pan224/TDC_UART/data_record.md

# 数据记录

> 注意：SEL000本身无数据。

## 第一次测试

### 数据信息

#### Merged 数据 (只含有 data.csv 的合并数据)

<details>
<summary>SEL001 - SCAN_100R_100P_20260108_141721</summary>

**Test Mode:** SCAN
**Timestamp:** 2026-01-08 14:17:21.764595

| Step | CSA | Samples | Mean (ps) | Variance | Std Dev (ps) |
| ---- | ----- | --- | --- | --- | --- |
| 0 | CSA_0 | 10000 | 11837.41  | 157.28 | 12.54 |
| 1 | CSA_1 | 10000 | 6955.51 | 224.47 | 14.98 |
| 2 | CSA_2 | 10000 | 2215.33 | 244.02 | 15.62 |
| 3 | CSA_3 | 10000 | -2492.48  | 244.08 | 15.62 |
| 4 | CSA_4 | 10000 | -7285.21  | 146.60 | 12.11 |
| 5 | CSA_5 | 10000 | -12098.23 | 164.15 | 12.81 |

</details>

<details>
<summary>SEL010 - SCAN_100R_100P_20260108_141454</summary>

**Test Mode:** SCAN
**Timestamp:** 2026-01-08 14:14:54.629893

| Step | CSA | Samples | Mean (ps) | Variance | Std Dev (ps) |
| ---- | ----- | --- | --- | --- | --- |
| 0 | CSA_0 | 10000 | 26645.60  | 172.76 | 13.14 |
| 1 | CSA_1 | 10000 | 15942.25  | 197.63 | 14.06 |
| 2 | CSA_2 | 10000 | 5293.12 | 251.64 | 15.86 |
| 3 | CSA_3 | 10000 | -5483.55  | 212.18 | 14.57 |
| 4 | CSA_4 | 10000 | -16218.55 | 261.02 | 16.16 |
| 5 | CSA_5 | 10000 | -26937.88 | 108.08 | 10.40 |

</details>

<details>
<summary>SEL011 - SCAN_100R_100P_20260108_141252</summary>

**Test Mode:** SCAN
**Timestamp:** 2026-01-08 14:12:52.722446

| Step | CSA | Samples | Mean (ps) | Variance | Std Dev (ps) |
| ---- | ----- | --- | --- | --- | --- |
| 0 | CSA_0 | 10000 | 35184.73  | 291.71 | 17.08 |
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
| 3 | CSA_3 | 10000 | -11804.49 | 150.87 | 12.28 |
| 4 | CSA_4 | 10000 | -35306.07 | 202.76 | 14.24 |
| 5 | CSA_5 | 10000 | -58854.17 | 250.13 | 15.82 |

</details>

<details>
<summary>SEL110 - SCAN_100R_100P_20260108_150920</summary>

**Test Mode:** SCAN
**Timestamp:** 2026-01-08 15:09:21.059514

| Step | CSA | Samples | Mean (ps) | Variance | Std Dev (ps) |
| ---- | ----- | --- | --- | --- | --- |
| 0 | CSA_0 | 10000 | 73347.67  | 222.75 | 14.92 |
| 1 | CSA_1 | 10000 | 43995.64  | 237.52 | 15.41 |
| 2 | CSA_2 | 10000 | 14653.28  | 172.40 | 13.13 |
| 3 | CSA_3 | 10000 | -14735.75 | 148.98 | 12.21 |
| 4 | CSA_4 | 10000 | -44152.21 | 220.49 | 14.85 |
| 5 | CSA_5 | 10000 | -73620.59 | 248.90 | 15.78 |

</details>

<details>
<summary>SEL111 - SCAN_100R_100P_20260108_151229</summary>

**Test Mode:** SCAN
**Timestamp:** 2026-01-08 15:12:29.540880

| Step | CSA | Samples | Mean (ps) | Variance | Std Dev (ps) |
| ---- | ----- | --- | --- | --- | --- |
| 0 | CSA_0 | 10000 | 81916.04  | 323.14 | 17.98 |
| 1 | CSA_1 | 10000 | 49102.85  | 239.94 | 15.49 |
| 2 | CSA_2 | 10000 | 16363.34  | 155.50 | 12.47 |
| 3 | CSA_3 | 10000 | -16432.14 | 123.28 | 11.10 |
| 4 | CSA_4 | 10000 | -49276.20 | 205.43 | 14.33 |
| 5 | CSA_5 | 10000 | -82184.24 | 321.65 | 17.93 |

</details>

#### 数据分析

---

**单位延时分析 - 第一次测试 (2026-01-08)**

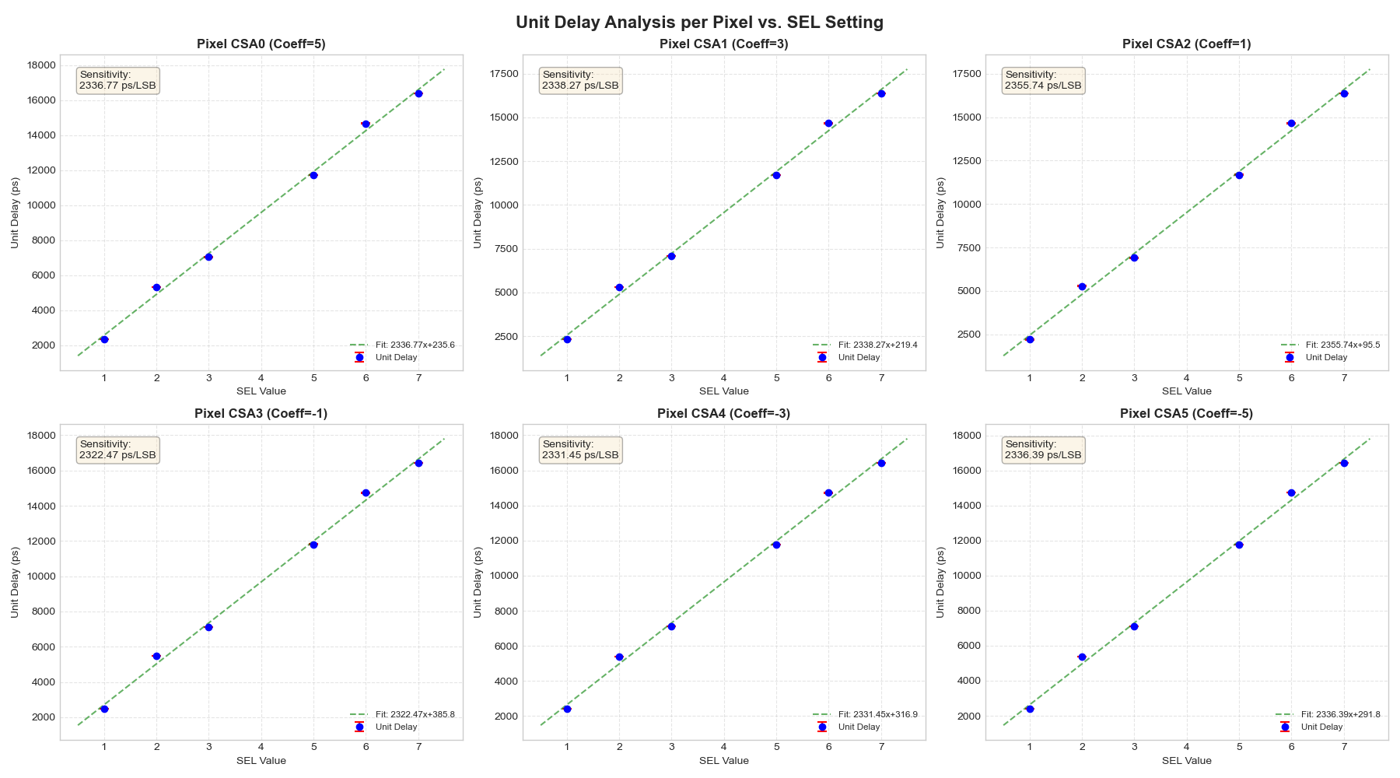
[picture p1: data/Unit_Delay_Analysis_20260108_165742.png]


**单位延时分析 - 修正后对比 (2026-01-21)**

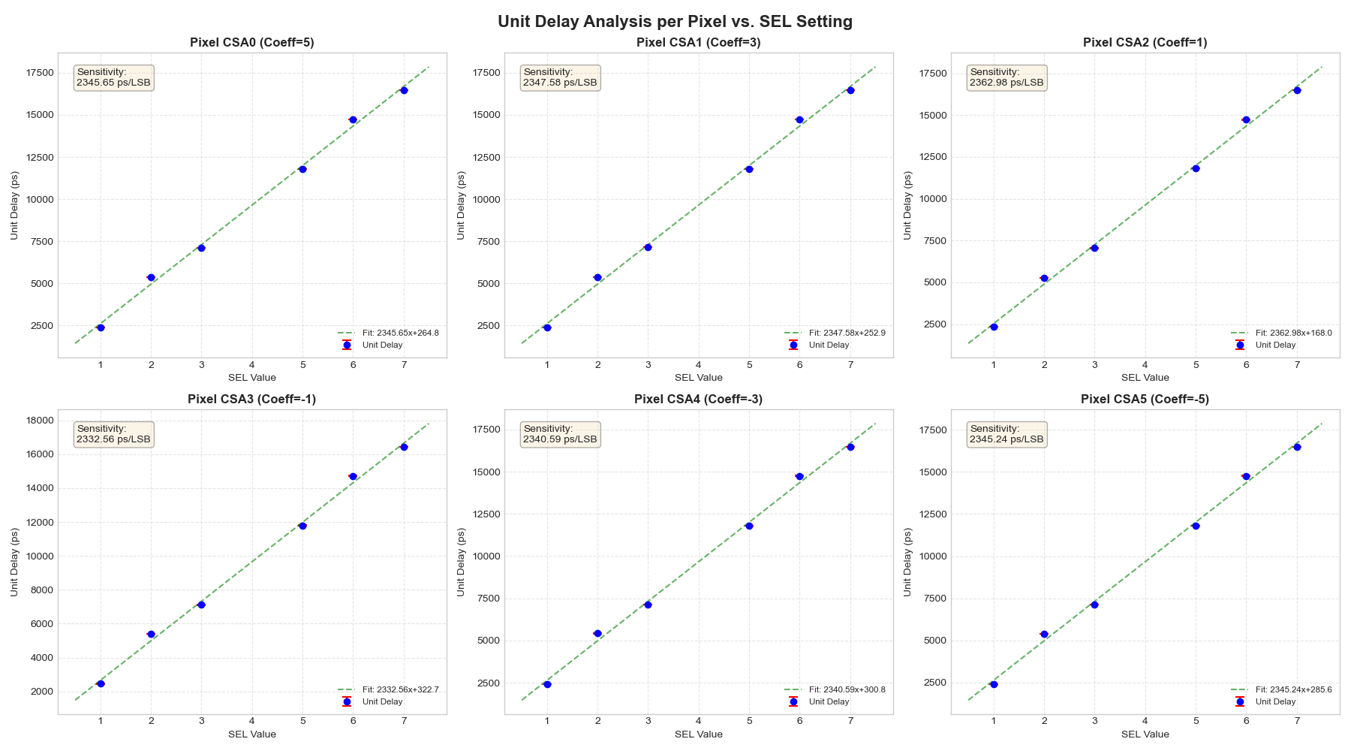
[picture p2: data/Unit_Delay_Analysis_20260121_174906.png]


---

### 数据记录说明

**测试硬件：** 初代测试板
**测试日期：** 2026-01-08
**数据类型：** 两组

**主要发现：**

- 无法采集 SEL100 数据，怀疑硬件问题
- 成功采集其他 SEL 配置的完整数据

**数据组成：**

1. **Merged 数据** - 仅包含 data.csv 合并数据
2. **CSA Split 数据** - 包含 CSA0-CSA5 各通道独立数据

## 第二次测试

### 数据信息

- 时间：2026-01-21
- 测试数据：CSA Split
- 注：SEL100 缺失

<details>
<summary>SEL001 - SCAN_100R_100P_20260121_172647</summary>

**Test Mode:** SCAN
**Timestamp:** 2026-01-21 17:26:47.961069

| Step | CSA | Samples | Mean (ps) | Variance | Std Dev (ps) |
| ---- | ----- | --- | --- | --- | --- |
| 0 | CSA_0 | 10000 | 11989.13  | 93.80 | 9.68 |
| 1 | CSA_1 | 10000 | 7083.89 | 82.24 | 9.07 |
| 2 | CSA_2 | 10000 | 2344.18 | 82.53 | 9.08 |
| 3 | CSA_3 | 10000 | -2456.50  | 94.73 | 9.73 |
| 4 | CSA_4 | 10000 | -7252.38  | 91.81 | 9.58 |
| 5 | CSA_5 | 10000 | -12091.16 | 117.69 | 10.85 |

</details>

<details>
<summary>SEL010 - SCAN_100R_100P_20260121_172841</summary>

**Test Mode:** SCAN
**Timestamp:** 2026-01-21 17:28:41.288427

| Step | CSA | Samples | Mean (ps) | Variance | Std Dev (ps) |
| ---- | ----- | --- | --- | --- | --- |
| 0 | CSA_0 | 10000 | 26882.59  | 113.91 | 10.67 |
| 1 | CSA_1 | 10000 | 16103.95  | 107.02 | 10.35 |
| 2 | CSA_2 | 10000 | 5275.56 | 96.07 | 9.80 |
| 3 | CSA_3 | 10000 | -5394.46  | 108.51 | 10.42 |
| 4 | CSA_4 | 10000 | -16246.74 | 89.51 | 9.46 |
| 5 | CSA_5 | 10000 | -26997.04 | 102.31 | 10.11 |

</details>

<details>
<summary>SEL011 - SCAN_100R_100P_20260121_173049</summary>

**Test Mode:** SCAN
**Timestamp:** 2026-01-21 17:30:49.272076

| Step | CSA | Samples | Mean (ps) | Variance | Std Dev (ps) |
| ---- | ----- | --- | --- | --- | --- |
| 0 | CSA_0 | 10000 | 35470.05  | 132.57 | 11.51 |
| 1 | CSA_1 | 10000 | 21401.14  | 121.46 | 11.02 |
| 2 | CSA_2 | 10000 | 7041.95 | 80.69 | 8.98 |
| 3 | CSA_3 | 10000 | -7104.07  | 90.13 | 9.49 |
| 4 | CSA_4 | 10000 | -21347.91 | 132.44 | 11.51 |
| 5 | CSA_5 | 10000 | -35547.15 | 131.29 | 11.46 |

</details>

<details>
<summary>SEL100 - 示波器测试数据</summary>

**Test Mode:** OSCILLOSCOPE
**Timestamp:** 2026-01-21
**Note:** SEL100脉冲幅度约 200mV

---

**CSA0 通道 (测量值: 47720 ps)**

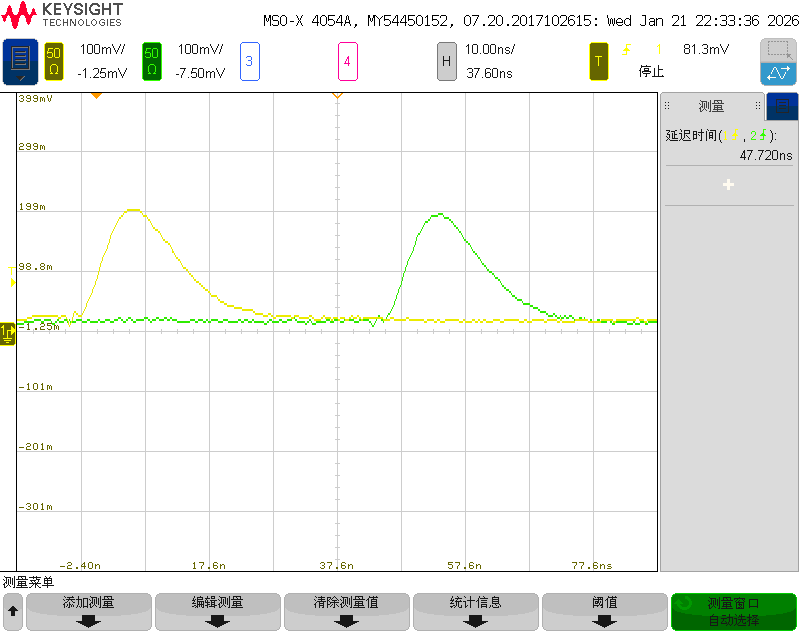
[picture p3: data/SEL100/示波器测试数据/CSA0.png]
CSA0波形


**CSA1 通道 (测量值: 26244 ps)**

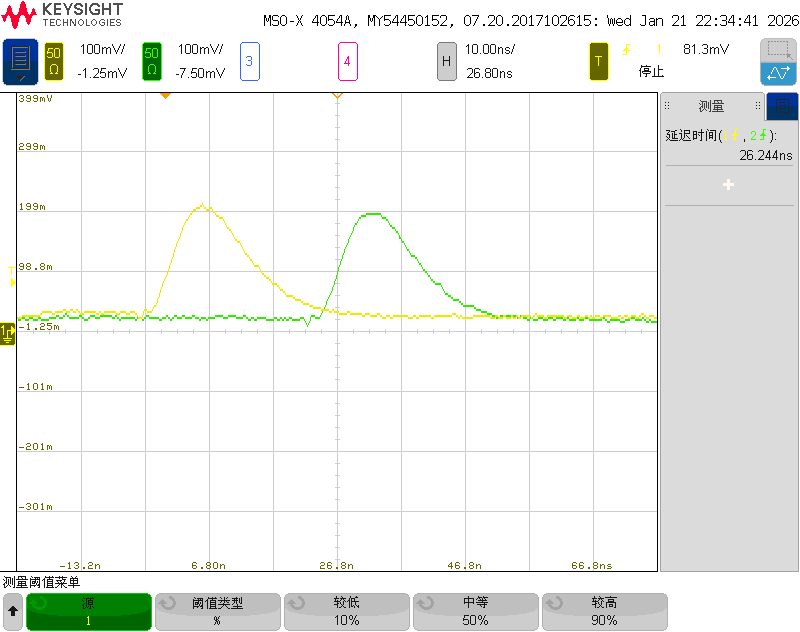
[picture p4: data/SEL100/示波器测试数据/CSA1.png]
CSA1波形


**CSA2 通道 (测量值: 8852 ps)**

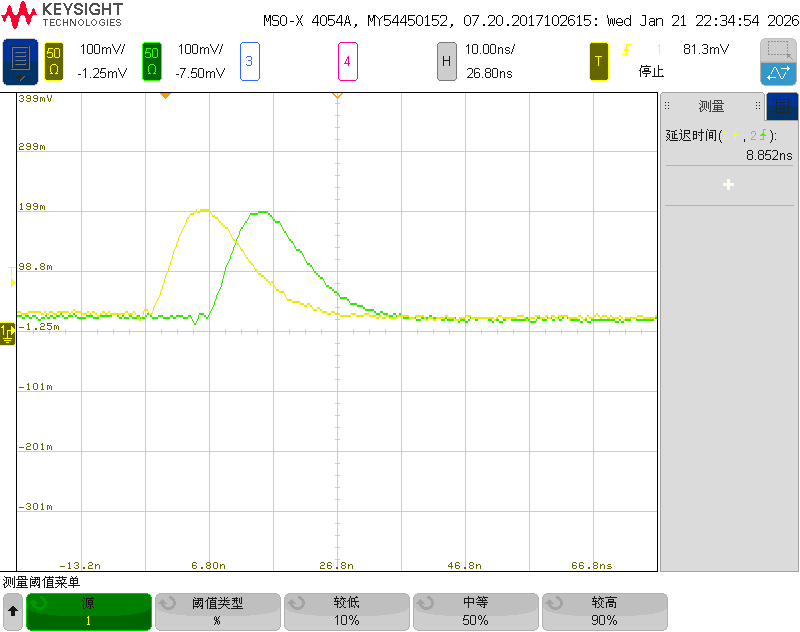
[picture p5: data/SEL100/示波器测试数据/CSA2.png]
CSA2波形


**CSA3 通道 (测量值: -10577 ps)**

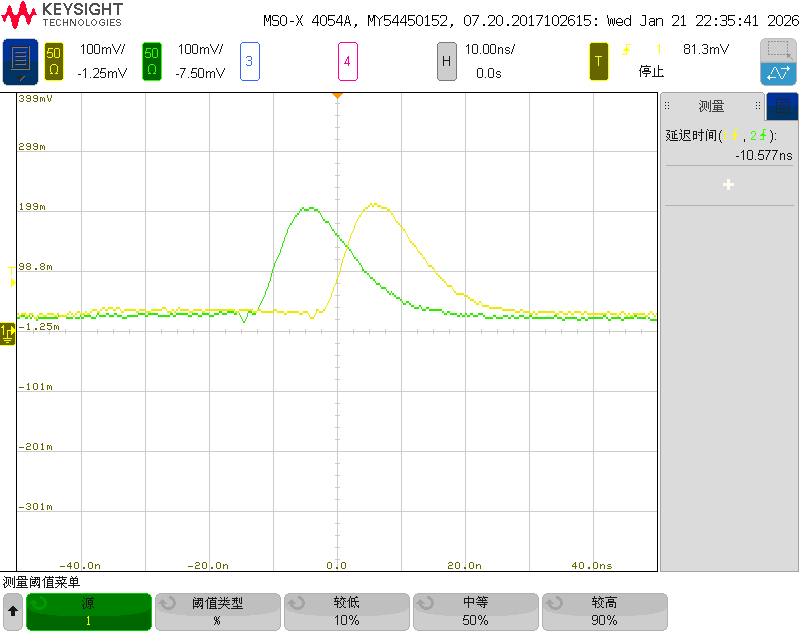
[picture p6: data/SEL100/示波器测试数据/CSA3.png]
CSA3波形


**CSA4 通道 (测量值: -27960 ps)**

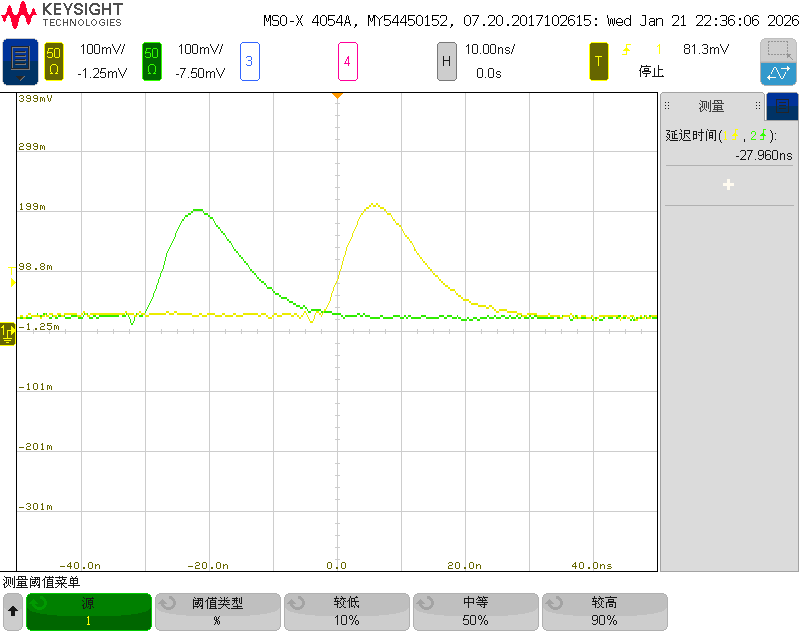
[picture p7: data/SEL100/示波器测试数据/CSA4.png]
CSA4波形


**CSA5 通道 (测量值: -45367 ps)**

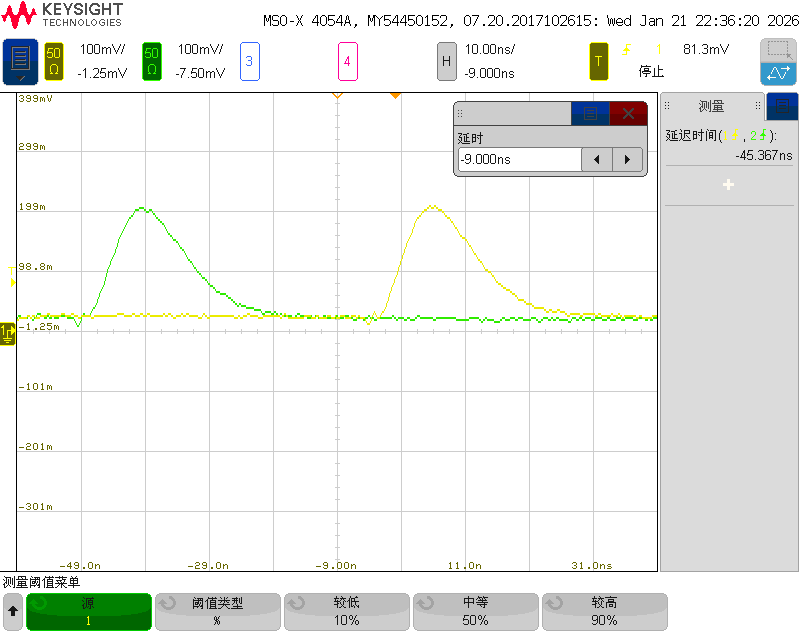
[picture p8: data/SEL100/示波器测试数据/CSA5.png]
CSA5波形


---

**测量数据汇总**

| 通道 | 时间差 (ps) |
| ---- | --- |
| CSA0 | 47720 |
| CSA1 | 26244 |
| CSA2 | 8852 |
| CSA3 | -10577 |
| CSA4 | -27960 |
| CSA5 | -45367 |

</details>

<details>
<summary>SEL101 - SCAN_100R_100P_20260121_173301</summary>

**Test Mode:** SCAN
**Timestamp:** 2026-01-21 17:33:01.628801

| Step | CSA | Samples | Mean (ps) | Variance | Std Dev (ps) |
| ---- | ----- | --- | --- | --- | --- |
| 0 | CSA_0 | 10000 | 58955.12  | 187.81 | 13.70 |
| 1 | CSA_1 | 10000 | 35338.72  | 142.73 | 11.95 |
| 2 | CSA_2 | 10000 | 11828.26  | 112.20 | 10.59 |
| 3 | CSA_3 | 10000 | -11795.52 | 92.89 | 9.64 |
| 4 | CSA_4 | 10000 | -35399.06 | 121.82 | 11.04 |
| 5 | CSA_5 | 10000 | -59046.35 | 200.68 | 14.17 |

</details>

<details>
<summary>SEL110 - SCAN_100R_100P_20260121_173655</summary>

**Test Mode:** SCAN
**Timestamp:** 2026-01-21 17:36:55.768046

| Step | CSA | Samples | Mean (ps) | Variance | Std Dev (ps) |
| ---- | ----- | --- | --- | --- | --- |
| 0 | CSA_0 | 10000 | 73734.26  | 223.46 | 14.95 |
| 1 | CSA_1 | 10000 | 44232.12  | 181.41 | 13.47 |
| 2 | CSA_2 | 10000 | 14728.77  | 94.31 | 9.71 |
| 3 | CSA_3 | 10000 | -14722.61 | 94.14 | 9.70 |
| 4 | CSA_4 | 10000 | -44262.89 | 180.69 | 13.44 |
| 5 | CSA_5 | 10000 | -73844.62 | 221.73 | 14.89 |

</details>

<details>
<summary>SEL111 - SCAN_100R_100P_20260121_173451</summary>

**Test Mode:** SCAN
**Timestamp:** 2026-01-21 17:34:51.170206

| Step | CSA | Samples | Mean (ps) | Variance | Std Dev (ps) |
| ---- | ----- | --- | --- | --- | --- |
| 0 | CSA_0 | 10000 | 82389.86  | 239.30 | 15.47 |
| 1 | CSA_1 | 10000 | 49418.06  | 163.49 | 12.79 |
| 2 | CSA_2 | 10000 | 16501.09  | 118.09 | 10.87 |
| 3 | CSA_3 | 10000 | -16444.45 | 103.70 | 10.18 |
| 4 | CSA_4 | 10000 | -49427.68 | 165.79 | 12.88 |
| 5 | CSA_5 | 10000 | -82470.95 | 227.06 | 15.07 |

</details>

#### 数据分析

---

**单位延时分析 - 第二次测试 (2026-01-21)**

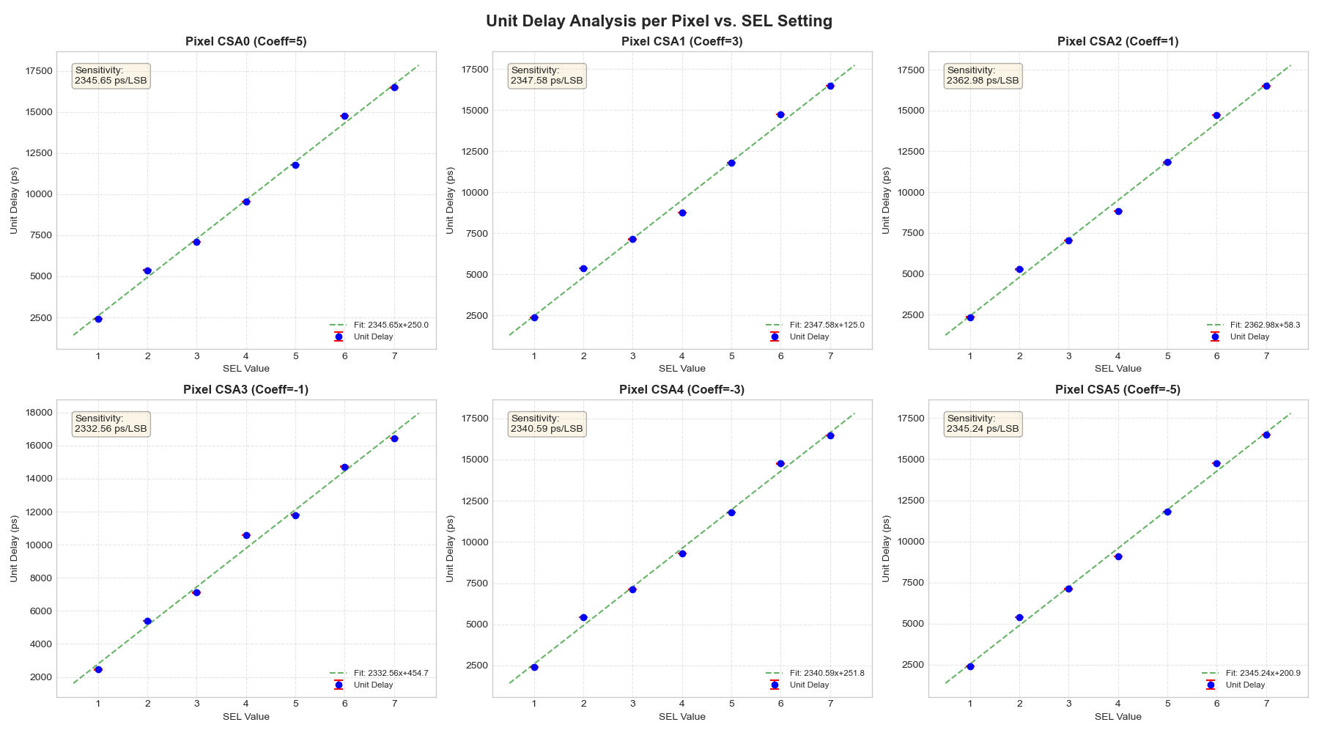
[picture p9: data/Unit_Delay_Analysis_20260121_213557.png]


> 注：此次测试附带了示波器采集的 SEL100 测试数据

---

### 数据记录说明

**测试硬件：** 重新焊接的新测试板
**测试日期：** 2026-01-21
**数据类型：** CSA Split

**重要改进：**

- 修正代码错误：260MHz 对应周期从 3864ps 更正为 3846ps
- 数据标准差显著降低，测量精度提升

**问题分析：**

- SEL100 数据仍无法通过 TDC 采集
- 根本原因：像素芯片输出脉冲幅度过小（约 200mV）
- 脉冲幅度不足以触发 TDC 系统的阈值

**解决方案：**
采用示波器直接测量 SEL100 输出波形时间差（详见上方示波器测试数据）

---

**示波器测量结果总结：**

| 通道 | 时间差 (ps) | 备注 |
| ---- | --- | --- |
| CSA0 | 47720 | 最大正延时 |
| CSA1 | 26244 | |
| CSA2 | 8852 | |
| CSA3 | -10577 | |
| CSA4 | -27960 | |
| CSA5 | -45367 | 最大负延时 |

> 注：SEL100 脉冲幅度在示波器下测得约 200mV

---

## 第三次测试

### 测试内容

**测试日期：** 2026-03-25
**测试方式：** 内部记录信号（UP/DOWN 双通道）全步进统计
**数据文件时间戳：** 2026-03-25 09:06:59

### 数据信息

- 扫描范围：Phase Step 0~224（共 225 点）
- 每个相位点配对样本数：3000
- 统计数据文件：`full_phase_stats_0_224_20260325_094752.csv`
- 输出四子图：`full_phase_stats_0_224_20260325_094752.png`

#### 关键统计汇总

| 指标 | UP 通道 | DOWN 通道 |
| --- | --- | --- |
| 均值范围（Phase 0~224） | 36.733~3805.460 ps | 31.414~3808.775 ps |
| 标准差均值（过滤异常点） | 13.064 ps | 12.283 ps |
| 过滤异常点（Phase 200~205） | 6个 | 6个 |

#### 数据分析图

**UP/DOWN 均值与标准差（按 Phase Step）**

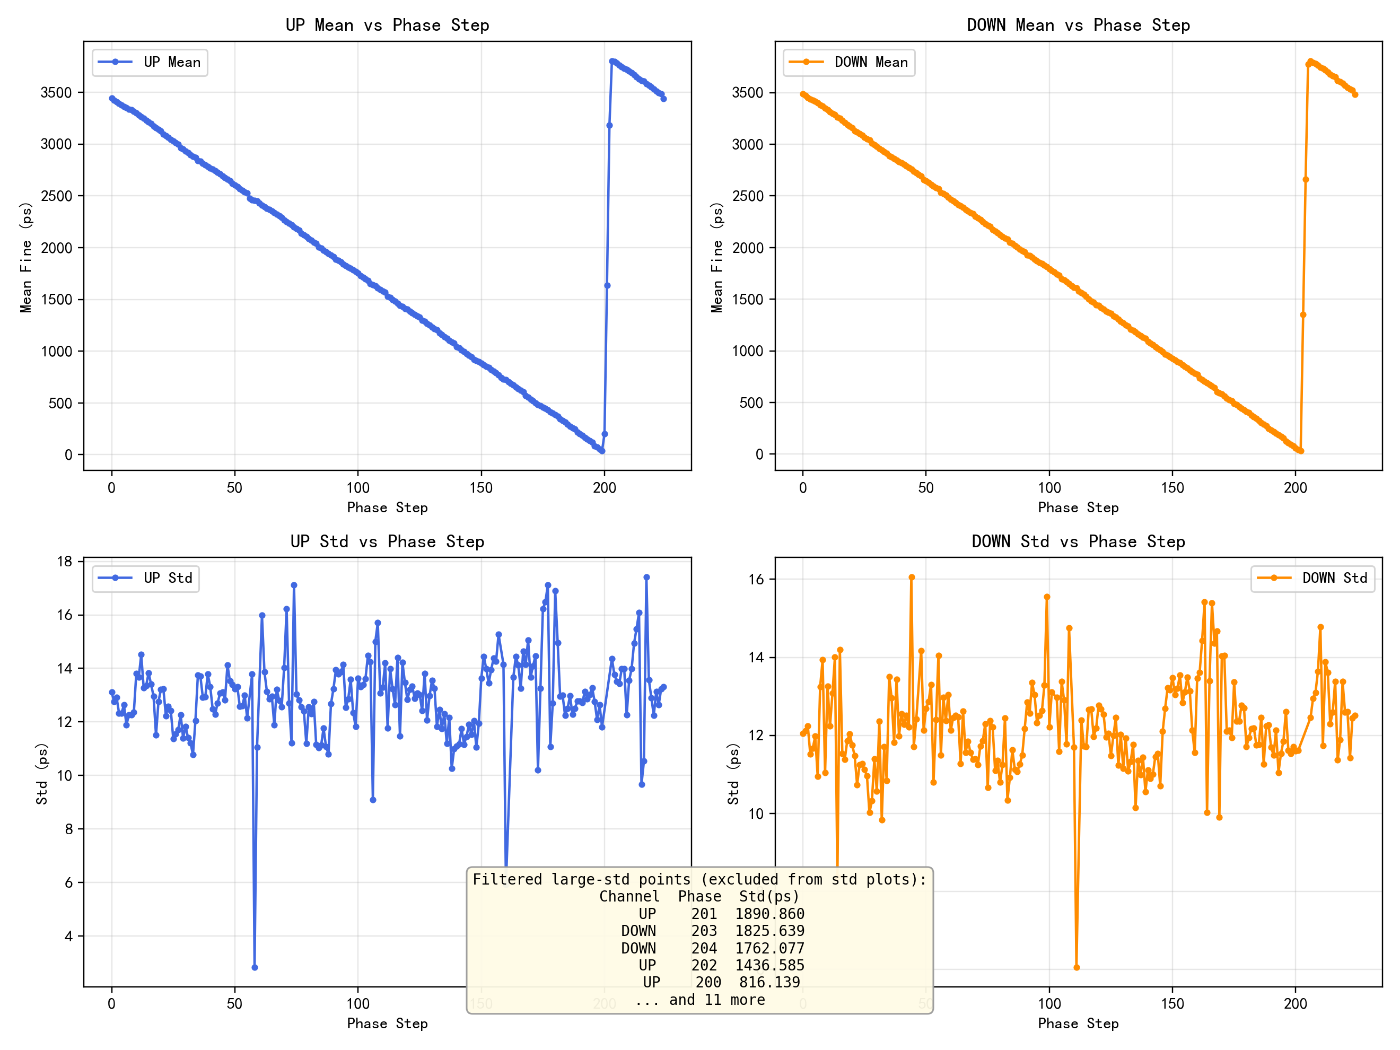
[picture p10: tdc_results/full_phase_stats_0_224_20260325_094752.png]
第三次测试四子图


- 四子图图表已生成，展示 Phase 0~224 全范围数据
- 上图：UP/DOWN 通道均值对比（线性趋势）
- 下图：UP/DOWN 通道标准差对比（异常点已标注）

---

## 第四次测试

### 测试内容

**测试日期：** 2026-03-25
**测试方式：** UART 全扫描（UP/DOWN 同步记录）
**原始数据文件：** `tdc_uart_全扫描_both_20260325_090659.txt`

### 数据信息

- 扫描步进：0~224（共 225 点）
- 每步记录：UP 1 点 + DOWN 1 点
- 总记录数：450 条（UP 225 条，DOWN 225 条）
- 综合分析图：`tdc_uart_全扫描_both_20260325_090659.png`

#### 关键统计汇总

| 指标 | UP 通道 | DOWN 通道 |
| --- | --- | --- |
| Fine 范围 | 6~3822 | 18~3840 |
| Coarse 范围 | 116~117 | 138~139 |
| 截断后线性拟合斜率（图中） | ~0.997 ps/ps | ~0.998 ps/ps |
| 线性度指标（图中） | DNL RMS = 0.887 LSB | INL RMS = 0.777 LSB |

#### 数据分析图

**全扫描综合分析（Fine/Coarse、线性拟合、DNL/INL）**

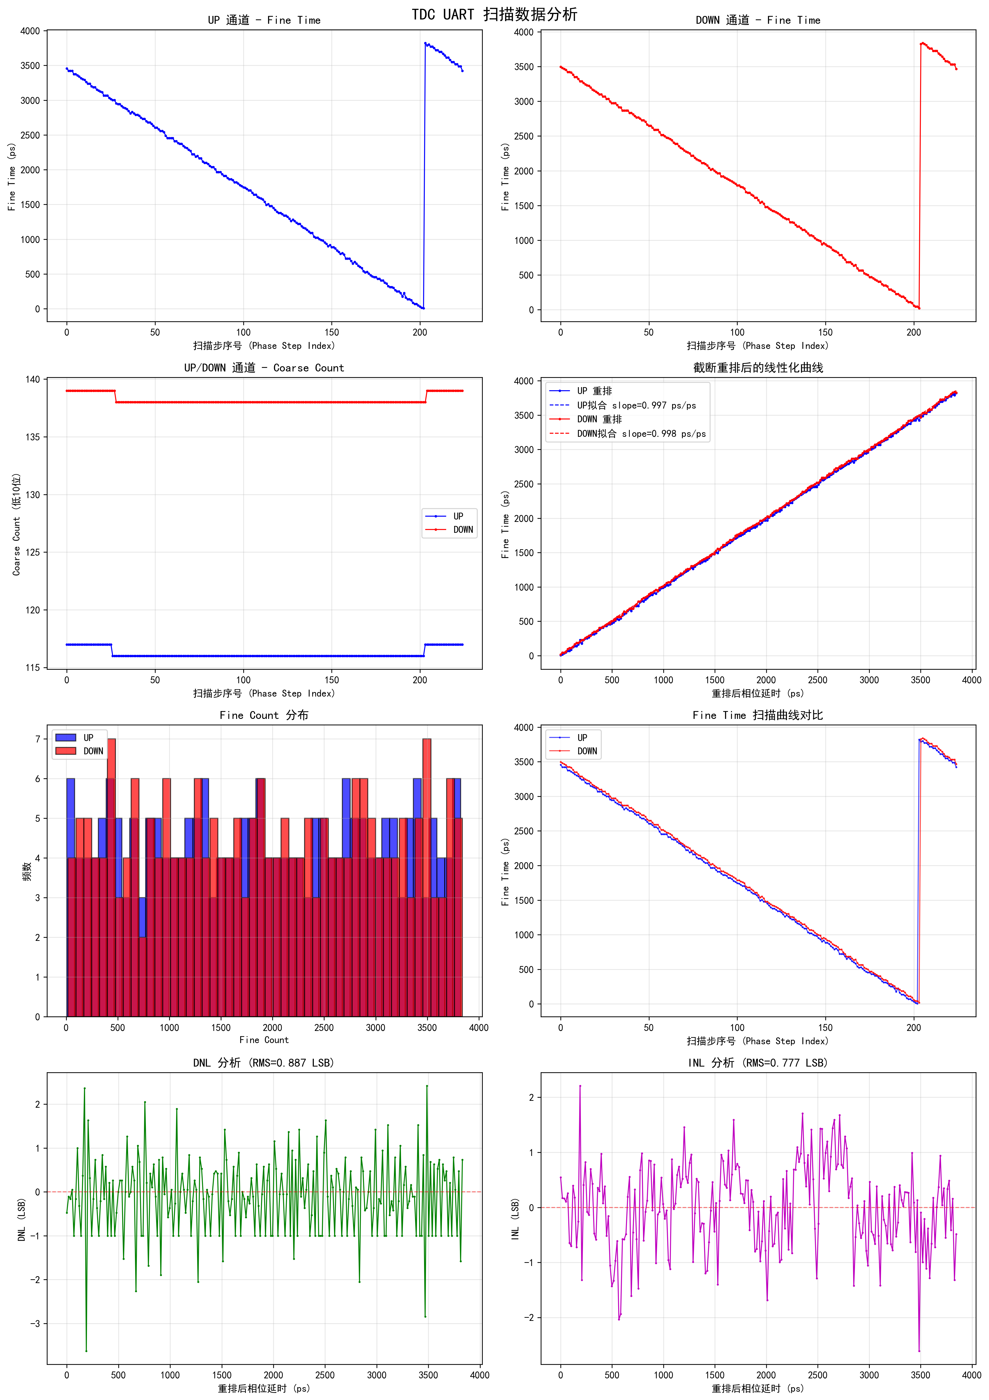
[picture p11: tdc_results/tdc_uart_全扫描_both_20260325_090659.png]
全扫描综合分析图


**图中结论（关键点）：**

- UP/DOWN Fine 曲线在主区间基本线性，约在 Phase 200 附近出现翻转（计数回绕）
- Coarse 计数稳定在窄范围内（UP: 116-117，DOWN: 138-139）
- 截断后拟合曲线显示 UP/DOWN 斜率一致性较好
- DNL/INL 均处于较小 RMS 区间，整体线性度表现稳定
