pan224/TDC_UART/data/SEL001/SCAN_100R_100P_20260121_172647/analysis_plot.png

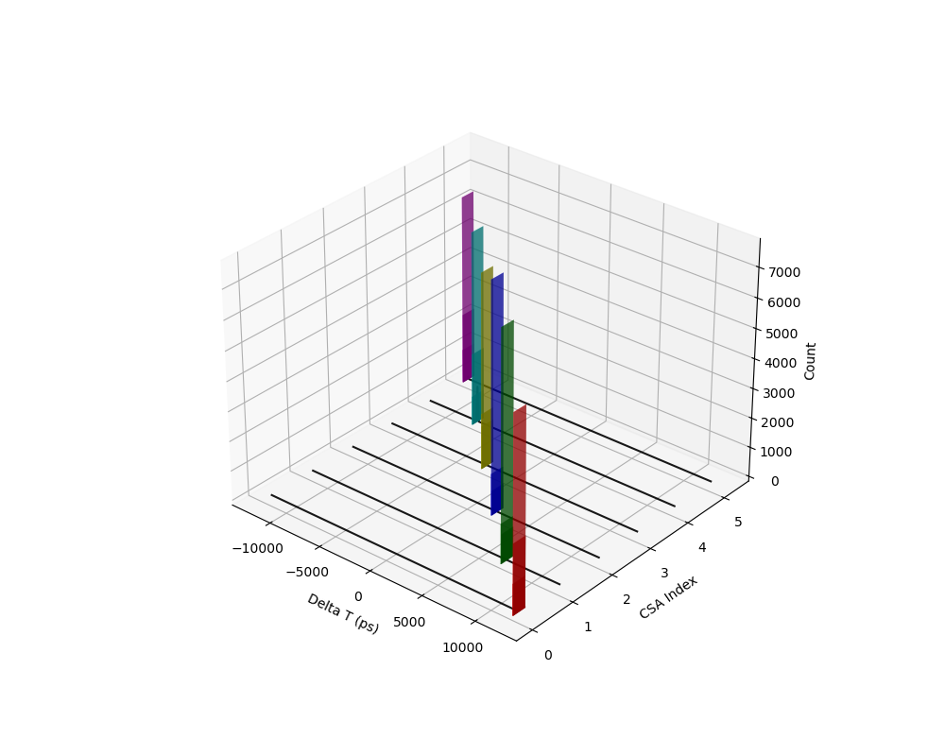
data/SEL001/SCAN_100R_100P_20260121_172647/analysis_plot.png
