pan224/TDC_UART/tdc_results/full_phase_stats_0_224_20260325_094752.csv

phase | valid_pairs | up_mean_ps | up_var_ps2 | up_std_ps | down_mean_ps | down_var_ps2 | down_std_ps
0 | 3000 | 3442.133333 | 172.073556 | 13.117681 | 3486.451000 | 145.099599 | 12.045729
1 | 3000 | 3425.267333 | 162.701866 | 12.755464 | 3470.178333 | 147.031197 | 12.125642
2 | 3000 | 3407.602667 | 166.858126 | 12.917358 | 3452.416000 | 149.738944 | 12.236787
3 | 3000 | 3393.896667 | 152.088656 | 12.332423 | 3439.053000 | 132.682858 | 11.518805
4 | 3000 | 3377.633667 | 152.044133 | 12.330618 | 3425.560333 | 136.147027 | 11.668206
5 | 3000 | 3364.103333 | 159.679322 | 12.636428 | 3413.706000 | 143.576231 | 11.982330
6 | 3000 | 3352.900000 | 141.532000 | 11.896722 | 3403.185667 | 119.966528 | 10.952923
7 | 3000 | 3338.623333 | 150.220789 | 12.256459 | 3379.205333 | 175.463838 | 13.246276
8 | 3000 | 3332.157000 | 150.494351 | 12.267614 | 3368.684000 | 194.164811 | 13.934303
9 | 3000 | 3316.962667 | 152.659273 | 12.355536 | 3351.288667 | 121.976672 | 11.044305
10 | 3000 | 3299.014667 | 190.626452 | 13.806754 | 3334.443667 | 175.834827 | 13.260272
11 | 3000 | 3279.770333 | 186.966920 | 13.673585 | 3314.914333 | 149.860995 | 12.241773
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
