pan224/TDC_UART/tdc_results/GUI_data/1.csv

Time | Ch | ID | Coarse | Fine | CoarseDiff | Delta_ps | RawHex
20:49:22.750 | UP | 0 | 201 | 1789 |  |  | 0x000DFBC9
20:49:22.750 | DOWN | 0 | 220 | 1066 | 19 | 73416.37 | 0x400854DC
20:49:22.750 | UP | 1 | 111 | 2103 |  |  | 0x00506F6F
20:49:22.750 | DOWN | 1 | 130 | 1396 | 19 | 73408.86 | 0x404AE882
20:49:22.750 | UP | 2 | 21 | 2553 |  |  | 0x0093F315
20:49:22.750 | DOWN | 2 | 40 | 1800 | 19 | 73430.46 | 0x408E1028
20:49:22.750 | UP | 3 | 187 | 2926 |  |  | 0x00D6DDBB
20:49:22.750 | DOWN | 3 | 206 | 2204 | 19 | 73415.90 | 0x40D138CE
20:49:22.750 | UP | 4 | 97 | 3341 |  |  | 0x011A1B61
20:49:22.750 | DOWN | 4 | 116 | 2592 | 19 | 73428.58 | 0x41144074
20:49:22.750 | UP | 5 | 7 | 3687 |  |  | 0x015CCF07
20:49:22.750 | DOWN | 5 | 26 | 2957 | 19 | 73419.66 | 0x41571A1A
20:49:22.750 | UP | 6 | 172 | 187 |  |  | 0x018177AC
20:49:22.750 | DOWN | 6 | 192 | 3325 | 20 | 75449.78 | 0x4199FAC0
20:49:22.750 | UP | 7 | 82 | 606 |  |  | 0x01C4BD52
20:49:22.750 | DOWN | 7 | 102 | 3744 | 20 | 75449.78 | 0x41DD4066
20:49:22.750 | UP | 8 | 248 | 940 |  |  | 0x020759F8
20:49:22.750 | DOWN | 8 | 11 | 244 | 19 | 73403.70 | 0x4201E80B
20:49:22.750 | UP | 9 | 158 | 1356 |  |  | 0x024A999E
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
