pan224/TDC_UART/tdc_results/GUI_data/2.csv

Time | Ch | ID | Coarse | Fine | CoarseDiff | Delta_ps | RawHex
21:02:26.541 | UP | 216 | 101 | 223 |  |  | 0x3601BF65
21:02:26.541 | DOWN | 216 | 121 | 3383 | 19* | 71593.30 | 0x761A6E79
21:02:26.541 | UP | 217 | 11 | 625 |  |  | 0x3644E30B
21:02:26.541 | DOWN | 217 | 31 | 3765 | 19* | 71602.69 | 0x765D6A1F
21:02:26.541 | UP | 218 | 177 | 987 |  |  | 0x3687B7B1
21:02:26.541 | DOWN | 218 | 196 | 226 | 19 | 73434.21 | 0x7681C4C4
21:02:26.541 | UP | 219 | 87 | 1346 |  |  | 0x36CA8557
21:02:26.541 | DOWN | 219 | 106 | 619 | 19 | 73418.25 | 0x76C4D66A
21:02:26.541 | UP | 220 | 253 | 1775 |  |  | 0x370DDFFD
21:02:26.541 | DOWN | 220 | 16 | 1043 | 19 | 73420.60 | 0x77082610
21:02:26.541 | UP | 221 | 163 | 2131 |  |  | 0x3750A7A3
21:02:26.541 | DOWN | 221 | 182 | 1396 | 19 | 73422.01 | 0x774AE8B6
21:02:26.541 | UP | 222 | 73 | 2506 |  |  | 0x37939549
21:02:26.541 | DOWN | 222 | 92 | 1767 | 19 | 73423.88 | 0x778DCE5C
21:02:26.541 | UP | 223 | 239 | 2907 |  |  | 0x37D6B7EF
21:02:26.541 | DOWN | 223 | 2 | 2161 | 19 | 73427.17 | 0x77D0E202
21:02:26.541 | UP | 224 | 149 | 3357 |  |  | 0x381A3B95
21:02:26.541 | DOWN | 224 | 168 | 2618 | 19 | 73423.88 | 0x781474A8
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
