pan224/TDC_UART/tdc_results/GUI_data/3.csv

Time | Ch | ID | Coarse | Fine | CoarseDiff | FineDiff | Delta_ps | RawHex
21:26:56.892 | UP | 188 | 202 | 2186 |  |  |  | 0x2F1115CA
21:26:56.892 | DOWN | 188 | 221 | 1410 | 19 | -776 | 73441.26 | 0x6F0B04DD
21:26:56.892 | UP | 189 | 112 | 2575 |  |  |  | 0x2F541F70
21:26:56.892 | DOWN | 189 | 131 | 1827 | 19 | -748 | 73428.11 | 0x6F4E4683
21:26:56.893 | UP | 190 | 22 | 2906 |  |  |  | 0x2F96B516
21:26:56.893 | DOWN | 190 | 41 | 2161 | 19 | -745 | 73426.70 | 0x6F90E229
21:26:56.893 | UP | 191 | 188 | 3273 |  |  |  | 0x2FD993BC
21:26:56.893 | DOWN | 191 | 207 | 2518 | 19 | -755 | 73431.40 | 0x6FD3ACCF
21:26:56.893 | UP | 192 | 98 | 3709 |  |  |  | 0x301CFB62
21:26:56.893 | DOWN | 192 | 117 | 2957 | 19 | -752 | 73429.99 | 0x70171A75
21:26:56.893 | UP | 193 | 7 | 200 |  |  |  | 0x30419107
21:26:56.893 | DOWN | 193 | 27 | 3338 | 20 | 3138 | 75449.78 | 0x705A141B
21:26:56.893 | UP | 194 | 173 | 568 |  |  |  | 0x308471AD
21:26:56.893 | DOWN | 194 | 193 | 3686 | 20 | 3118 | 75459.17 | 0x709CCCC1
21:26:56.893 | UP | 195 | 83 | 957 |  |  |  | 0x30C77B53
21:26:56.893 | DOWN | 195 | 102 | 227 | 19 | -730 | 73419.66 | 0x70C1C666
21:26:56.893 | UP | 196 | 249 | 1344 |  |  |  | 0x310A81F9
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
