pan224/TDC_UART/tdc_results/tdc_uart_全扫描_both_20260409_131519.png

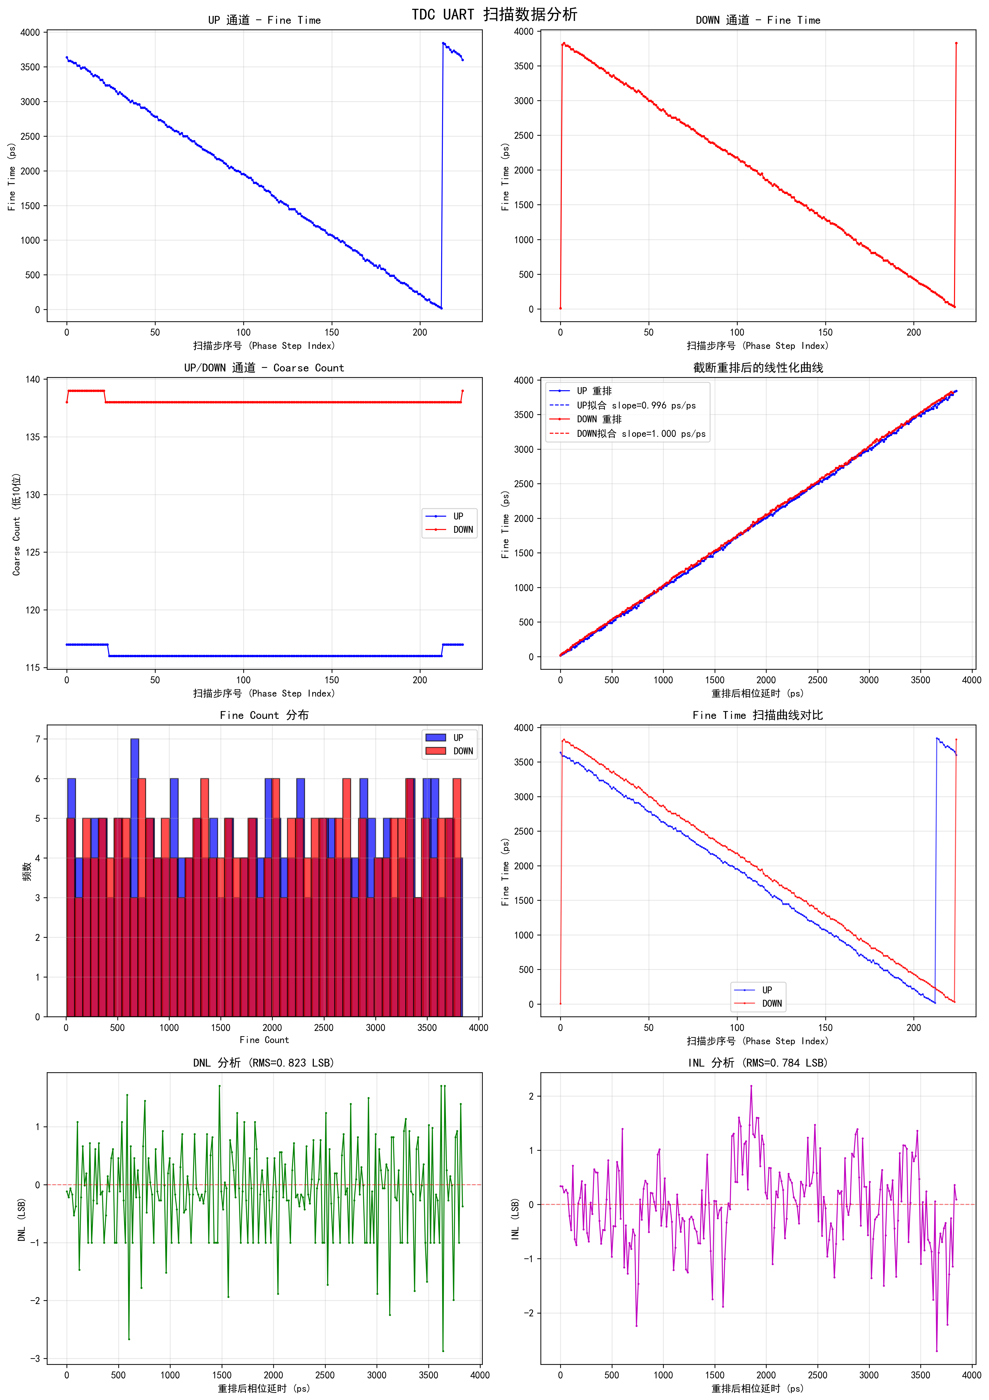
tdc_results/tdc_uart_全扫描_both_20260409_131519.png
