pan224/TDC_UART/tdc_results/扫描，粗计数在channel外进行.png

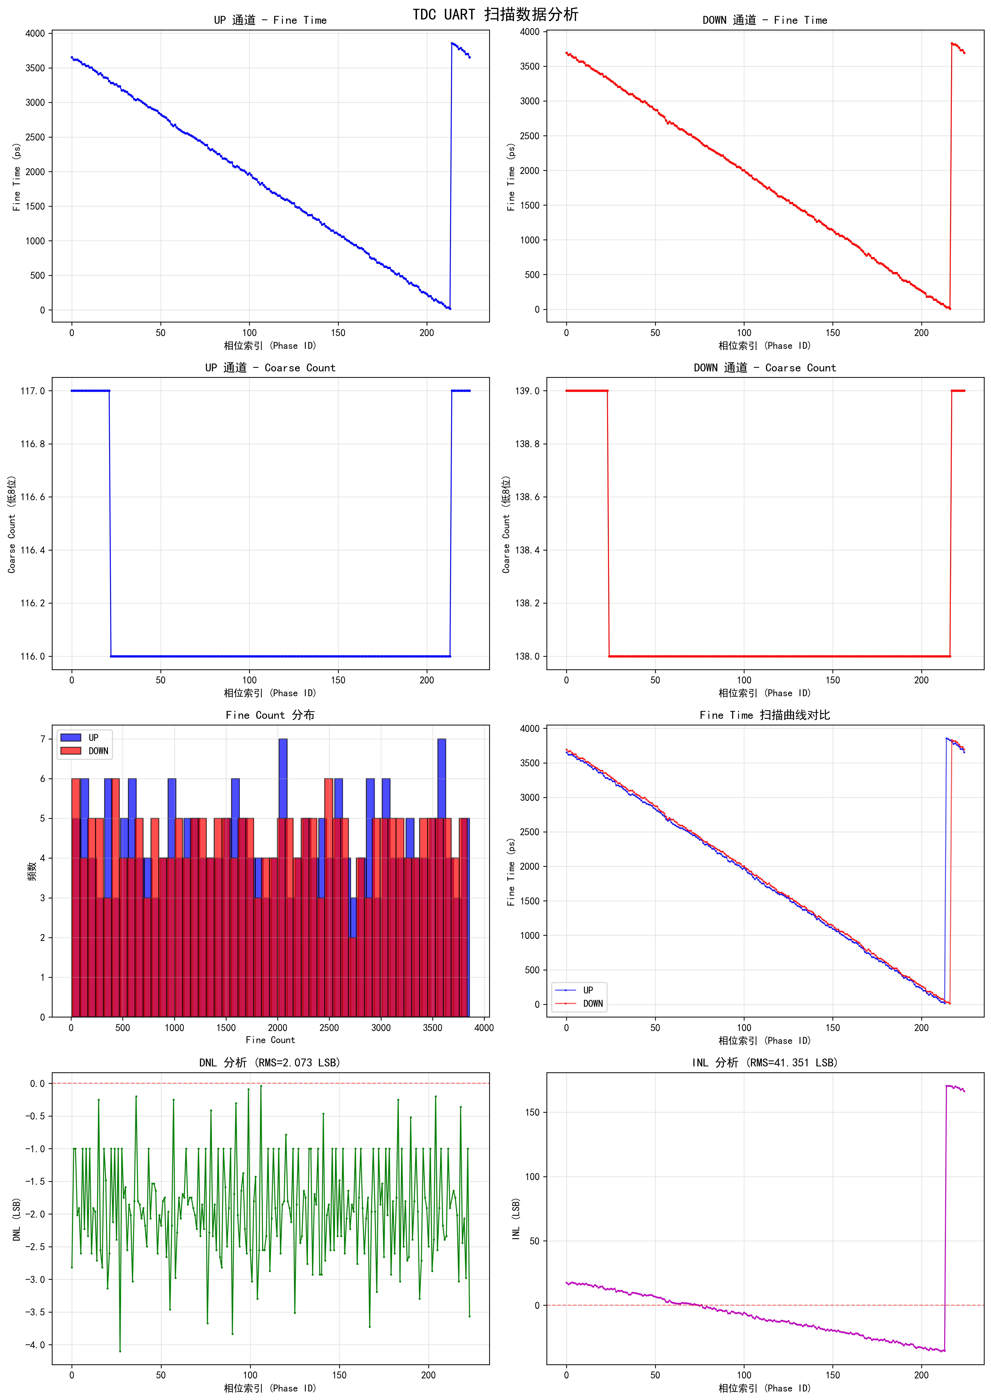
tdc_results/扫描，粗计数在channel外进行.png
