pan224/TDC_UART/(commit log)

2026-01-08 基于UART的时间数字转化器（TDC），用于和6像素芯片对接
    [1.csv, 2.csv, 3.csv, CSA0.csv, CSA1.csv, CSA2.csv, CSA3.csv, CSA4.csv]
2026-01-08 更新readme文件
2026-01-21 更新readme文件和数据
    [CSA0.csv, CSA1.csv, CSA2.csv, CSA3.csv, CSA4.csv, CSA5.csv]
2026-01-21 更新了SEL为100的delta_ps数据
2026-01-22 更新md文件，添加示波器测试数据，更新数据分析上位机默认使用的数据（SEL100使用示波器的数据）
2026-01-22 修复md在github上的渲染问题
2026-03-24 添加内部激励的数据处理GUI
2026-03-25 更新内部激励测试数据和方式
    [full_phase_stats_0_224_20260325_094752.csv]
2026-04-09 修改通道的LOC布局，更对称
